churruscat/Weather-station/(commit log)

2020-11-29 New version
    replaced nodered by adho program
    [1stDevice.h, ESP12-BME280.ino, mqtt_mosquitto.h, mqtt_mosquitto.ino]
2020-11-29 Version 2
    node-red replaced by mqttdbs, an adho program thatreads a mqttbroker and stores records in influxdb.
    [1stDevice.h, ESP12-BME280.ino, mqtt_mosquitto.h, mqtt_mosquitto.ino]
